roanlane/SLLmic/балка.SLDPRT

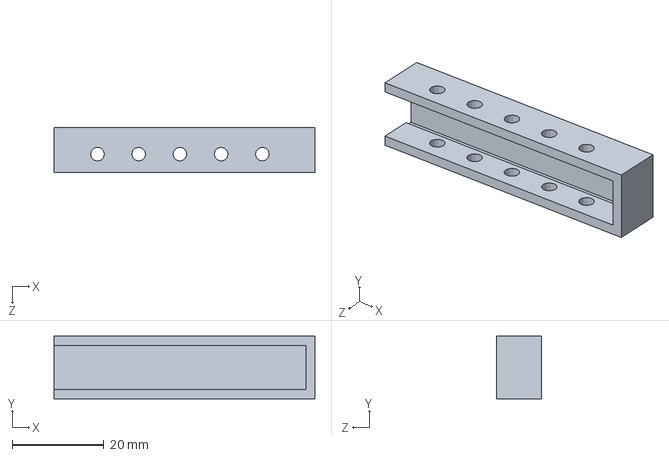
[picture p6: CAD file, 2017-12-06]
балка.SLDPRT
57.0 x 13.7 x 9.80 mm
