roanlane/SLLmic/крестовина.SLDPRT

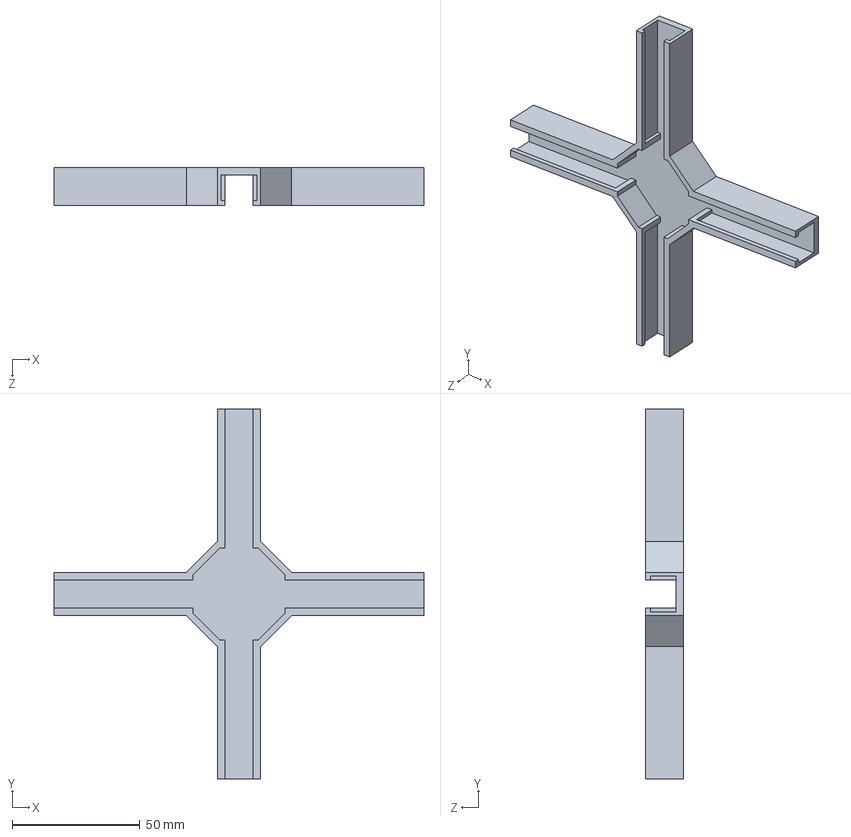
[picture p7: CAD file, 2017-12-06]
крестовина.SLDPRT
145.0 x 145.0 x 15.0 mm
