roanlane/SLLmic/Деталь1.SLDPRT

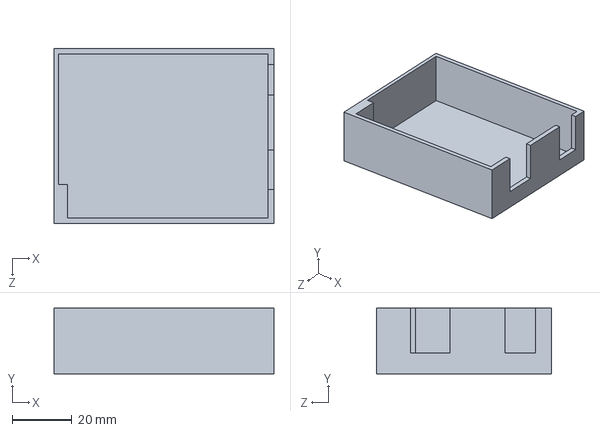
[picture p8: CAD file, 2017-12-06]
Деталь1.SLDPRT
73.6 x 22.0 x 58.5 mm
