roanlane/SLLmic/стойка.SLDPRT

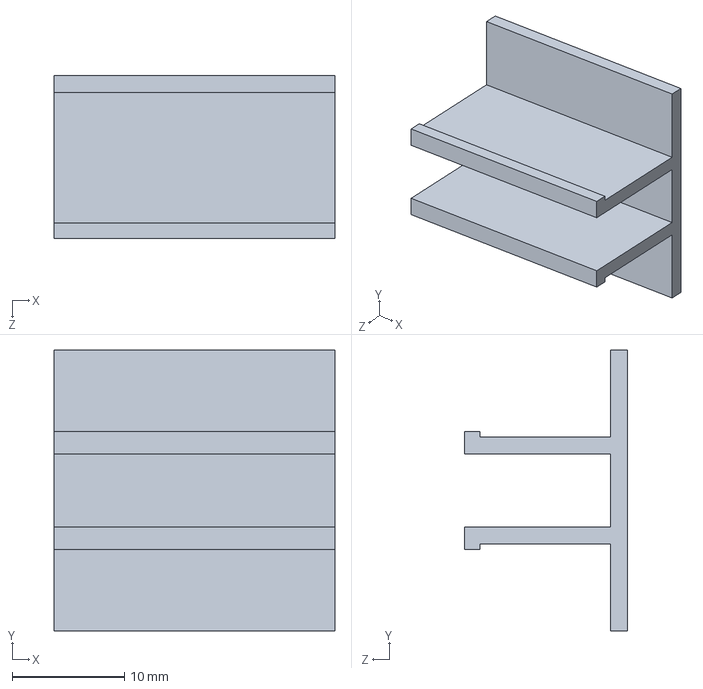
[picture p9: CAD file, 2017-12-06]
стойка.SLDPRT
25.0 x 25.0 x 14.5 mm
