roanlane/SLLmic/Деталь2.SLDPRT

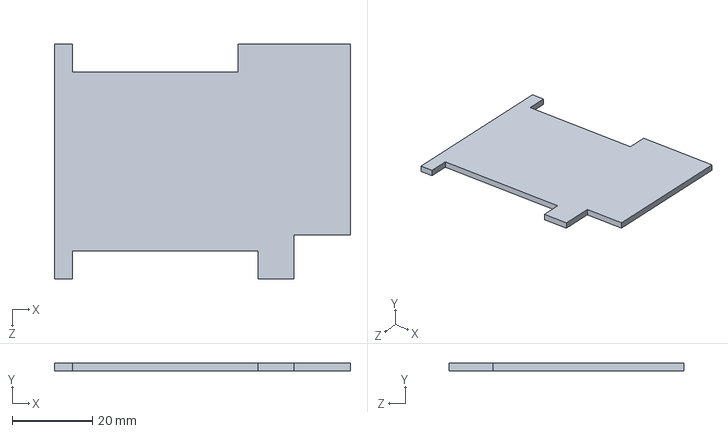
[picture p10: CAD file, 2017-12-06]
Деталь2.SLDPRT
73.6 x 2.00 x 58.5 mm
